davidkingsman/split-flap/(list of files, drawings)

Other design files:
PCB/EasyEDA_Source/PCB_PCB_Splitflap_2022-06-04.json
PCB/EasyEDA_Source/SCH_SplitFlap_2022-06-04.json
