davidkingsman/split-flap/(threads)

Thread 1 (2021-06-21):

V2 version idea: ESP32 with A4988

Oxmaster, 2021-06-21:
ESP32 has more than 21 GPIO pins needed for 10 flaps version, so with single MCU you could do all the work. Unless I am missing something.

Tie A4988 DIR pin to make it only spin in one way.

2 pins per flap: STEP and hall sensor output.
1 pin for ENA on all A4988 drivers.

Additionally: add 12V LED strip support to illuminate the flaps and LDR to auto change the brightness.

Dave19171, 2021-06-22:
Feel free to make a version 2.
A version with fewer microcontrollers would certainly be a bit cheaper and less power-hungry, but not with A4988. I saw prices from $4 to $7 per piece.
My idea would be to use the ULN2003 with shift registers if that's possible. But the code would have to be written almost from scratch.

Closed 2021-07-14.

Thread 2 (2021-07-14):

Unit Frame Assembly Missing Holes for M3 nuts

ThomDyson, 2021-07-14:
First, thank you so much for this project. I've had to learn Arduino and how to order custom PCBs, so this great.

In the instructions, section 5.2.2 says "Push two M3 nuts diagonally in the back of the frame. Use a screw to pull the nut if necessary."

I think this is to mount the stepper motor, but there are no holes in the unit frame for the M3 nuts under the stepper motor.

Dave19171, 2021-07-14:
This is not to mount the stepper motor, you need M4 screws for that. These are for attaching the frame to the HousingFrame
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

ThomDyson, 2021-07-14:
Got it. Thanks.

Closed 2021-07-14.

Thread 3 (2021-07-16):

CAP-SMD_L3.2-W1.6 What part?

TheBekker, 2021-07-16:
Can you help specifying the "CAP-SMD_L3.2-W1.6" part?

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

Dave19171, 2021-07-16:
Are you aware, that you need only one PCB with all the parts? Read the instructions on page 7 for details. There is also a table with each part on page 5.

I used this capacitor originally: https://lcsc.com/product-detail/Tantalum-Capacitors_TORCH-CA45-A-10V-22%CE%BCF-K_C503893.html
It does not seem to be in stock anymore.
The data sheet for the AMS1117-3.3 says: "The circuit design used in the AMS1117 series requires the use of
an output capacitor as part of the device frequency compensation. The addition of 22µF solid tantalum on the output will ensure
stability for all operating conditions. "

Since you only need one, I suggest you get one elsewhere and solder it yourself.  You need a
22uF >5V tantalum capacitor in 0805 size.

TheBekker, 2021-07-16:
Ahh i just saw that the instructions are only on PrusaPrinters :)
Bit confusing that half is here and other ther :)

I'll check the instructions, thanks!

Dave19171, 2021-07-16:
Just the instructions for the code on here. Everything electromechanical is on prusaprinters.

Closed 2021-07-16.

Thread 4 (2021-08-07):

ESP01 communication with unit not working / how to debug

rkuerbitz, 2021-08-07:
Dear David, first of all thanks for sharing your great design! I am in progress of making a version with laser-cut flaps out of 0.8 mm black acrylic with cut-plot letters - I will share those files when I've got them working.

However, I can't get the ESP01 communicate with the unit. I debugged the unit and put in some additional output via serial console and have the unit working properly and go to all letters fine. I put in some more serial message into unit to see if unit gets any messages from the ESP - receiveLetter in the unit never fires.

So perhaps you do have a hint on how to debug the ESP01; I am not sure how to see the output of #serial on the IDE (while it is plugged into the unit board).

Thanks in advance for any hints.

Dave19171, 2021-08-07:
Hey,
the debugging of the ESP01 is indeed not easy when it is plugged in on the board. My solution was to use a NodeMCU with a USB port and just plug in the SDA, SCL and GND pins with jumper wires.

But regarding your problem, if the slaves do not react and the ESP sends a message, it is most likely an I2C issue.
Try to confirm that the hardware is correctly assembled:

- You soldered the two BSS138 (Q1, Q2) correctly to your master board
- The four 10K pull-ups (R1-R4) are in place
- These components are just on the master board with the ESP01

If your hardware is assembled correctly, you need a logic analyzer to troubleshoot the I2C bus. There are cheap units under $10 available.

rkuerbitz, 2021-08-10:
Dear David, thanks for the hints. I was able to debug the Master Code using a NodeMCU board as suggested and I found the error: I hadn't adapted the UNITSAMOUNT when testing with my first 2 assembled units and thus got stuck in the error loop. Everything is working perfectly now.

I am currently working on a 3 rows x 16 columns display using 3 masters. I'll try to adapt the Master code a little using D12 and D13 on the units as Row ID.

Dave19171, 2021-08-10:
I would recommend adapting the code and saving the unit's information (Address and in your case row) in the EEPROM. That way you could have as many units as you like (or as there are I2C addresses, which is ~128).

rkuerbitz, 2021-08-10:
Good idea using the EEPROM. I will publish my code when I'm done (will take some weeks...). Thanks again.

Closed 2021-08-15.

Thread 5 (2021-08-11):

unit.ino not compiling when #define test uncommented

sergios100, 2021-08-11:
Hi Dave,

First let me congratulate you for that exellent project!
I am still building the clock, as parts arrive step by step from China.
I tried to upload the unit.ino file to my chinese Arduino Nanos, which worked after I switched to "ATmega328P (Old Bootloader) in "Tools" -> "Processor".
Upload went fine. But as soon as I uncomment Line 6: "#define test" it will not compile anymore and is throwing the following error:

```
Arduino: 1.8.13 (Windows 10), Board: "Arduino Nano, ATmega328P (Old Bootloader)"
...\split-flap-master\unit\unit.ino: In function 'void loop()':

unit:134:36: error: cannot convert 'String' to 'int' for argument '1' to 'void rotateToLetter(int)'

     rotateToLetter(currentCalLetter);

                                ^

exit status 1

cannot convert 'String' to 'int' for argument '1' to 'void rotateToLetter(int)'
```
Seems to be some sort of type conversion error.
Could you have a look at it? I don't get it at the moment. It seems that you want to be able to show these sequence: " ", "Z", "A", "U", "N", "?", "0", "1", "2", "9" but on the other hand the function rotateToLetter() seems to only take in integers (probably the numer of the tile which contains the desired letter?

Best Regards and many thanks!

Sergio

Dave19171, 2021-08-11:
You are totally correct, that test routine is from before I switched to integers for I2C communication. Characters were too unreliable. I will change the code accordingly.

ThomDyson, 2021-08-11:
Sergio,

Try changing line 131 from this

  String calLetters[10] = {" ", "Z", "A", "U", "N", "?", "0", "1", "2", "9"};

to  something like
 int calLetters[10[ = { 1, 26, 2, 20, 31, 32, 33, 34, 35, 39};

I don't know what letters that will produce, but it should solve the type problem.

Dave19171, 2021-08-11:
Fixed the issue by updating the test routine

Closed 2021-08-11.

Thread 8 (2021-10-16):

no ip-adress

anno006, 2021-10-16:
Can't find the esp01 within my network. The code uploads without an error. How can i 1. give it a static ip address or 2. what is the problem? also the serial monitor works not.

anno006, 2021-10-16:
> > Did you uncomment line 23 in the ESPMaster.ino? `//#define serial //uncomment for serial debug messages, no serial messages if this whole line is a comment!`
>
> Yes i did already.

But after rewriting, and rewriting, and etc. i do have now a error state from the serial monitor:

Connecting to WiFi .....scandone
state: 0 -> 2 (b0)
.state: 2 -> 0 (2)
reconnect
...scandone
state: 0 -> 2 (b0)
.state: 2 -> 0 (2)
reconnect
...scandone

anno006, 2021-10-16:
I try, but i get the hole day the error connection refused. That's why i try to find what is wrong, 2 weeks ago it did work.

Dave19171, 2021-10-16:
I can not really help you with that because your network is probably the issue. Here is a tutorial to configure a static IP-address for the library I am using: [https://randomnerdtutorials.com/esp8266-nodemcu-static-fixed-ip-address-arduino/](url)

Thread 9 (2021-12-26):

return false missing in FlapFunctions

Klimbim1, 2021-12-26:
Hi Dave,
my compiler from the Arduino IDE moans if the return false; is missing in the translateLetterToInt function is missing.
Mine looks now like this:

```
//translates char to letter position
int translateLettertoInt(char letterchar) {
  for (int i = 0; i < FLAPAMOUNT; i++) {
    if (letterchar == letters[i]) {
      return i;
    }
  }
  return false; //ADDED
}
```

Dave19171, 2022-01-02:
What version of the Arduino IDE are you using? Are you compiling for the board "Generic ESP8266 Module"?

I am trying to replicate the compiler error, but it compiles fine.
Also, this function's return type is `int`, I am confused why there should be a `return false` there.

Klimbim1, 2022-01-03:
I am using 1.8.19 and I did compile for Generic ESP8266 Module. Return type yes you're right, my fault should be return 0 then I guess?

The error message I get is:
`exit status 1
control reaches end of non-void function [-Werror=return-type]`

Klimbim1, 2022-01-10:
Any more ideas, @Dave19171?

Closed 2022-06-26.

Thread 10 (2022-02-15):

shortage of C5

lewpaw, 2022-02-15:
Hey Dave, thanks for this cool project.
I'm not an electronics expert, especially when it comes to soldering SMT elements, that's why I wanted to order these assembled from JLCPCB. However, they are in shortage of "CA45-A-10V-22μF-K" (C5). Can this be replaced with something similar? Can you recommend?
Thanks!

Dave19171, 2022-02-15:
You can think of SMD capacitors as normal ones. For our use case you only need to match the size (0805), capacity (22μF) and voltage (>=10V). C5 is a tiny bit special because it is a tantalum capacitor.

This seems to be the only equivalent currently in stock on LCSC: [https://lcsc.com/product-detail/Tantalum-Capacitors_ROHM-Semicon-TCTP1A226M8R_C2859526.html](https://lcsc.com/product-detail/Tantalum-Capacitors_ROHM-Semicon-TCTP1A226M8R_C2859526.html)

But you only need one for the power supply of the ESP01.
Maybe try searching on eBay and solder it yourself. If I require just a few of something, I usually find it there.

Hopsen, 2022-04-29:
Hi Dave, i also wanted to use jclpcb and their soldering service.
At the moment they are short of C2 and U4. Am I right I can replace C2 with "50V 100nF X7R ±10% 0805 Multilayer Ceramic Capacitors MLCC"??

Can U4 be replaced with "Texas Instruments ULN2003ADR"?

Dave19171, 2022-04-29:
> Hi Dave, i also wanted to use jclpcb and their soldering service. At the moment they are short of C2 and U4. Am I right I can replace C2 with "50V 100nF X7R ±10% 0805 Multilayer Ceramic Capacitors MLCC"??

Yes, a 50V cap will work as long as it is also 100nf and a 0805 package.

> Can U4 be replaced with "Texas Instruments ULN2003ADR"?
That one should work, it is still a ULN2003A. If I understand the datasheet correctly, it is just packaged differently.

Hopsen, 2022-04-30:
Thanks.

Closed 2023-06-13.

Thread 11 (2022-06-24):

Connecting and sending first text but not more

diablex2, 2022-06-24:
Hi,
Finished the project. Thank you very much for your effort to share it. Great documentation for a beginner like me.

I can connect to 10 digit unit with ip address of ESP01. I can send the first text message. But when I send a second message nothing happens. When I check the packets sent and received to esp01 from the router I see the packages sent. When I cut the power and power on again all digits turn to show blank flap than I see the last message (the message which lost) I sent before cutting the power.
So, for a new message on split flap I need to cut power and re connect it.
The clock shows up but it does not changing the minute digit. I think this is also related to my problem.

Could the community please share their opinions about the my problem?

Thank you in advance.

Dave19171, 2022-06-26:
Are you able to uncomment line 5 in one of the units and look at the serial monitor? I suspect it will show that the units are not correctly waking up from sleep.

You can test this by making line 97 to 120 in the unit code a comment. If this fixes it, your units are not correctly waking up.

diablex2, 2022-07-04:
Thank you very much for your attention Dave19171.
I am trying the solution you proposed. As I am working on it in the evenings it will take some time but I will share the result here.

diablex2, 2022-11-24:
> Thank you very much for your attention Dave19171. I am trying the solution you proposed. As I am working on it in the evenings it will take some time but I will share the result here.

Sorry for my late reply.  I tried the solution but not worked. I changed the first unit with a new soldered one.  And everything was working fine.  Thats my case.

Closed 2022-11-24.

Thread 12 (2022-07-19):

[Nano Every] "'ADCSRA' was not declared in this scope"

it-escher, 2022-07-19:
So i accidentally bought an "Arduino Nano Every" instead of a regular "Arduino Nano" which apparently uses a different chip (ATMega4809).

When i try to upload/verify the "unit" sketch im getting the following error:

`D:\3D Print\SplitFlap\split-flap-master\unit\unit.ino: In function 'void loop()':
unit:99:23: error: 'ADCSRA' was not declared in this scope
     byte old_ADCSRA = ADCSRA;
                       ^~~~~~
D:\3D Print\SplitFlap\split-flap-master\unit\unit.ino:99:23: note: suggested alternative: 'ADC_t'
     byte old_ADCSRA = ADCSRA;
                       ^~~~~~
                       ADC_t
unit:116:5: error: 'TWCR' was not declared in this scope
     TWCR = bit(TWEN) | bit(TWIE) | bit(TWEA) | bit(TWINT);
     ^~~~
D:\3D Print\SplitFlap\split-flap-master\unit\unit.ino:116:5: note: suggested alternative: 'TWI0'
     TWCR = bit(TWEN) | bit(TWIE) | bit(TWEA) | bit(TWINT);
     ^~~~
     TWI0
In file included from C:\Users\49160\Documents\ArduinoData\packages\arduino\hardware\megaavr\1.8.7\cores\arduino/api/Interrupts.h:8:0,
                 from C:\Users\49160\Documents\ArduinoData\packages\arduino\hardware\megaavr\1.8.7\cores\arduino/api/ArduinoAPI.h:29,
                 from C:\Users\49160\Documents\ArduinoData\packages\arduino\hardware\megaavr\1.8.7\cores\arduino/Arduino.h:23,
                 from D:\3D Print\SplitFlap\split-flap-master\unit\unit.ino:8:
unit:116:16: error: 'TWEN' was not declared in this scope
     TWCR = bit(TWEN) | bit(TWIE) | bit(TWEA) | bit(TWINT);
                ^
C:\Users\49160\Documents\ArduinoData\packages\arduino\hardware\megaavr\1.8.7\cores\arduino/api/Common.h:71:25: note: in definition of macro 'bit'
 #define bit(b) (1UL << (b))
                         ^
D:\3D Print\SplitFlap\split-flap-master\unit\unit.ino:116:16: note: suggested alternative: 'TWI0'
     TWCR = bit(TWEN) | bit(TWIE) | bit(TWEA) | bit(TWINT);
                ^
C:\Users\49160\Documents\ArduinoData\packages\arduino\hardware\megaavr\1.8.7\cores\arduino/api/Common.h:71:25: note: in definition of macro 'bit'
 #define bit(b) (1UL << (b))
                         ^
unit:116:28: error: 'TWIE' was not declared in this scope
     TWCR = bit(TWEN) | bit(TWIE) | bit(TWEA) | bit(TWINT);
                            ^
C:\Users\49160\Documents\ArduinoData\packages\arduino\hardware\megaavr\1.8.7\cores\arduino/api/Common.h:71:25: note: in definition of macro 'bit'
 #define bit(b) (1UL << (b))
                         ^
D:\3D Print\SplitFlap\split-flap-master\unit\unit.ino:116:28: note: suggested alternative: 'TWI0'
     TWCR = bit(TWEN) | bit(TWIE) | bit(TWEA) | bit(TWINT);
                            ^
C:\Users\49160\Documents\ArduinoData\packages\arduino\hardware\megaavr\1.8.7\cores\arduino/api/Common.h:71:25: note: in definition of macro 'bit'
 #define bit(b) (1UL << (b))
                         ^
unit:116:40: error: 'TWEA' was not declared in this scope
     TWCR = bit(TWEN) | bit(TWIE) | bit(TWEA) | bit(TWINT);
                                        ^
C:\Users\49160\Documents\ArduinoData\packages\arduino\hardware\megaavr\1.8.7\cores\arduino/api/Common.h:71:25: note: in definition of macro 'bit'
 #define bit(b) (1UL << (b))
                         ^
D:\3D Print\SplitFlap\split-flap-master\unit\unit.ino:116:40: note: suggested alternative: 'TWI0'
     TWCR = bit(TWEN) | bit(TWIE) | bit(TWEA) | bit(TWINT);
                                        ^
C:\Users\49160\Documents\ArduinoData\packages\arduino\hardware\megaavr\1.8.7\cores\arduino/api/Common.h:71:25: note: in definition of macro 'bit'
 #define bit(b) (1UL << (b))
                         ^
unit:116:52: error: 'TWINT' was not declared in this scope
     TWCR = bit(TWEN) | bit(TWIE) | bit(TWEA) | bit(TWINT);
                                                    ^
C:\Users\49160\Documents\ArduinoData\packages\arduino\hardware\megaavr\1.8.7\cores\arduino/api/Common.h:71:25: note: in definition of macro 'bit'
 #define bit(b) (1UL << (b))
                         ^
D:\3D Print\SplitFlap\split-flap-master\unit\unit.ino:116:52: note: suggested alternative: 'TWI_t'
     TWCR = bit(TWEN) | bit(TWIE) | bit(TWEA) | bit(TWINT);
                                                    ^
C:\Users\49160\Documents\ArduinoData\packages\arduino\hardware\megaavr\1.8.7\cores\arduino/api/Common.h:71:25: note: in definition of macro 'bit'
 #define bit(b) (1UL << (b))
                         ^
Using library Wire at version 1.0 in folder: C:\Users\49160\Documents\ArduinoData\packages\arduino\hardware\megaavr\1.8.7\libraries\Wire
Using library Stepper at version 1.1.3 in folder: C:\Program Files\WindowsApps\ArduinoLLC.ArduinoIDE_1.8.57.0_x86__mdqgnx93n4wtt\libraries\Stepper
Using library EEPROM at version 2.0 in folder: C:\Users\49160\Documents\ArduinoData\packages\arduino\hardware\megaavr\1.8.7\libraries\EEPROM
exit status 1
'ADCSRA' was not declared in this scope
`

Is there a way to rewrite / adapt the code for this processor by maybe "just" chaning the variable names of the registers or will this be a futile attempt and im better of just buying a regular Nano instead?

Greetings from Germany.

Dave19171, 2022-07-20:
The code to send the Nano to sleep is very specific to the ATMEGA 328p chip.
Try removing the following code:
```
 if (currentMillis - previousMillis >= WAIT_TIME) {
    byte old_ADCSRA = ADCSRA;
    // disable ADC
    ADCSRA = 0;
    set_sleep_mode (SLEEP_MODE_PWR_DOWN);
    sleep_enable();
#ifdef serial
    digitalWrite (LED_BUILTIN, LOW); // shuts off LED when starting to sleep, for debugging
#endif
    sleep_cpu ();
#ifdef serial
    digitalWrite (LED_BUILTIN, HIGH); // turns on LED when waking up, for debugging
#endif
    sleep_disable();
    previousMillis = currentMillis; //reset sleep counter
    ADCSRA = old_ADCSRA;

    // release TWI bus
    TWCR = bit(TWEN) | bit(TWIE) | bit(TWEA) | bit(TWINT);

    // turn it back on again
    Wire.begin (i2cAddress);
  }  // end of time to sleep
```

You could find a way to send the 4809 to sleep or live with the higher power consumption.

it-escher, 2022-07-22:
Thanks, that works for now!

Im gonna look into finding a way to rewrite this section for the Nano Every and might do a pull request if i succeed.

Closed 2022-07-22.

Thread 13 (2022-10-31):

replace TWI with SPI Daisy Chain

instaibil, 2022-10-31:
Hi Dave,

at frist awesome project.
and i think i will build it after christmas.

i have an idea for ESP -> Arduino Nano communication.
you get the I2C addresses via DIP Switches.
my idea, the same method as with the ws2812b.
 a kind of SPI daisy chain. you connect ESP -> split flap 0 -> split flap 1 ......

problem is, you need to have two SPI Interfaces on the MCU.
so thats not possible with the Nano, but maybe another Board like Nucle-G031.

but with my idea you don´t need the DIP Switches and the Display is not limited to 16 Segments.

so what do you think?
do you see any problems?

Thread 15 (2022-12-04):

Last 3 digits won´t spin correctly

NoI3ody, 2022-12-04:
Hello,

i have build your amazing splitflap... but i have a problem with the 3 last digits of my splitflap.
As you can see in the video, all flaps are calibrating, after that the 5 middle ones start rotating till they display the correct time. But while the 5 middle ones are rotating, the last 3 start rotating until they get a timeout.
https://youtu.be/CSe2SAsITus

I have no idea what´s going on here. Tried to switch the nanos, the units, the cables but i couldn´t get it right?
Anyone have a idea what i can test here?

Dave19171, 2022-12-05:
Have you tried enabling the serial output of the nanos and look at that? Maybe there is something going on with the power and not the code.

NoI3ody, 2022-12-09:
I enabled the serial and testet. The last 3 Units gets this code in serial monitor.
Could it be the power? I have a 3A powersource from a LED-strip.

I can´t post the serial monitor. I added a Screenshot of the beginning and the end of the rotation as the content between looks very similar to me.
Beginn of serial monitor:
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
End of serial monitor:
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

NoI3ody, 2022-12-25:
Any ideas, what the problem could be?

Dave19171, 2022-12-25:
I have no idea. Your serial output looks very weird. It starts formatted correctly, but then everything is in one line. I am still suspecting something with your power because of the gibberish characters in the serial output and the restarting in the middle of a line.

NoI3ody, 2023-01-07:
I found the problem. It was not the powersupply.
It was the ESP. The ESP sends for the last digits -1 when it has no data for the left over units. However my arduinos are converting -1 to 255 as you can see in the first letter received and after receiving 255 the code crashes. So i changed the errorhandling in FlapFunctions.ino Line 52 from -1 to 0. Now when i have an error or blank data it will display the blank tile.
With this change everything is working as it should.

Closed 2023-01-07.

Thread 16 (2022-12-08):

Where to get the letters?

EdwardDeaver, 2022-12-08:
Hi,

Thanks so much for making this! I was wondering though where did you get the letters?

Dave19171, 2022-12-08:
Look at the instructions on Printables: https://www.printables.com/model/69464-split-flap-display/files (scroll all the way down to other files).
The letters are printed in the flaps with color-swaps.

Closed 2022-12-08.

Thread 18 (2023-03-18):

Hall sensor/magnet specs

nils-van-zuijlen, 2023-03-18:
Hello,

I found out the hard way that KY-003 is not precise enough of a reference number, as I just got a set of latching sensors... (or at least, they latch with the magnets I have).

- Do you have a part number for the Hall sensor IC?
- Should I use radial magnets instead of the axial ones I have?

Thanks

Thread 20 (2023-09-28):

Why is the use of 12V stepper motors mandatory?

TheNoobInventor, 2023-09-28:
Hello @Dave19171,

I know you aren't actively maintaining and developing the code but I was hoping you could help clarify why using 12V stepper motors are important.

I plan to build my own split-flap display, I already have 5x 5V stepper motors, but came across your instruction document specifically recommending 12V steppers instead. Why is that? Thank you.

TheNoobInventor, 2023-10-02:
I looked through the project comments on [Printables](https://www.printables.com/model/69464-split-flap-display/comments) and found my answer. I put this here just in case someone else has a similar question.

TheNoobInventor, 2023-10-02:
I looked through the project comments on [Printables](https://www.printables.com/model/69464-split-flap-display/comments) and found my answer. I put this here just in case someone else has a similar question.

Closed 2023-10-02.

Thread 22 (2024-04-07):

Which include lib contains

racenviper, 2024-04-07:
compile errors out on avr/sleep.h line 12, where is this lib?

Dave19171, 2024-04-07:
The avr/sleep library should come with the Arduino IDE. Do you have the correct board type selected? The sleep library is only used in the unit code (The Arduino nanos).

racenviper, 2024-04-08:
I got it, there is so many different boards and trying to work with ESP32 also, i just personally hate Arduino. Thanks, I had to just step back and look at it again.

racenviper, 2024-04-08:
nw to figure out the ESP3201s

Thread 25 (2024-07-30):

Can't get ESP Master to communicate with flaps

Azer0s, 2024-07-30:
The flaps all home, SDA and SCL have continuity from flap 0 to flap 9 but I can't get them to communicate. I tried using a programmer for the ESP01 with pinouts and connected TX, RX and GND. I got this error message:
```
0:-1
Try to wake up unit
A unit in the display is sleeping
Waiting for display to stop
```
Do you maybe have an idea?
Fyi I have R1-R4, Q1-Q2. C5 and U9 on all PCBs. Can that cause the issue? It shouldn't cause it is just power delivery, right?

Azer0s, 2024-07-31:
Nvm I had the ESP01 in serial debug mode

Closed 2024-07-31.
