davidkingsman/split-flap/EEPROM_Write_Offset/EEPROM_Write_Offset.ino

//Code to write calibration offset into arduino EEPROM
#include <EEPROM.h>

int eeAddress = 0;   //Location we want the data to be put.
int calOffsetGet;  //Variable already in EEPROM.

//Serial input stuff
const byte numChars = 32;
char receivedChars[numChars]; // an array to store the received data
boolean newData = false;

void setup() {
  Serial.begin(115200);
  Serial.println("init");
  getData();
}

void loop() {
  recvWithEndMarker();
  showNewData();
}

void getData() {
  EEPROM.get(eeAddress, calOffsetGet);
  Serial.print("Offset already stored in EEPROM: ");
  Serial.print(calOffsetGet);
  Serial.println();
}

void writeToEEPROM(String offsetValue) {
  //Convert String to int
  int intOffsetValue = offsetValue.toInt();
  //One simple call, with the address first and the object second.
  EEPROM.put(eeAddress, intOffsetValue);

  Serial.print("Value written to EEPROM: ");
  Serial.print(intOffsetValue);
  Serial.println();
}

void recvWithEndMarker() {
  static byte ndx = 0;
  char endMarker = '\n';
  char rc;

  // if (Serial.available() > 0) {
  while (Serial.available() > 0 && newData == false) {
    rc = Serial.read();

    if (rc != endMarker) {
      receivedChars[ndx] = rc;
      ndx++;
      if (ndx >= numChars) {
        ndx = numChars - 1;
      }
    }
    else {
      receivedChars[ndx] = '\0'; // terminate the string
      ndx = 0;
      newData = true;
    }
  }
}

void showNewData() {
  if (newData == true) {
    writeToEEPROM(receivedChars);
    newData = false;
  }
}
