davidkingsman/split-flap/(commit log)

2021-06-14 added gerber files
2021-06-25 Update unit.ino
    Add sleep mode
    Unit sleeps if no i2c communication is happening
2021-08-11 fixed test routine
    Old test routine was still active, changed test routine (swapped chars with ints)
    [unit.ino]
2021-08-27 add common mistakes and how to fix
    [ESPMaster.ino, unit.ino]
2021-12-19 fixed test routine
    moved test routine from loop to setup. This way the sleep routine does not interfere.
    [unit.ino]
2022-03-11 Create BOM_PCB_Splitflap_2022-03-11.csv
    added BOM
    [BOM_PCB_Splitflap_2022-03-11.csv]
2022-06-04 add EasyEDA PCB Source files
    [PCB_PCB_Splitflap_2022-06-04.json, SCH_SplitFlap_2022-06-04.json]
2023-06-13 Update FlapFunctions.ino
    fixed "control reaches end of non-void function" error due to closed off return in if in function
    [FlapFunctions.ino]
2023-06-13 type comparisons mismatch fix
    Fixed error: comparison of integer expressions of different signedness
    [FlapFunctions.ino, stringHandling.ino]
2023-08-31 Updated string alignment methods
    - Left align string clears off any text to the right
    - Right align string implementation added
    - Center string when provided a long string, then subsequently a short string, did not clear the right hand side of the string
    [stringHandling.ino]
2024-04-14 add link to improved PCB
